dagdae/ClaudeDxfTest/(list of files, cad)

Other CAD files:
output/dxf/07BRW01_RACK-WIRING-ML-B01AM.dxf
output/dxf/07FRW01_RACK-WIRING-ML-F01AM.dxf
output/dxf/07FRW01_S02_NETWORK.dxf
