dagdae/ClaudeDxfTest/output/pdf/07BRW01.pdf

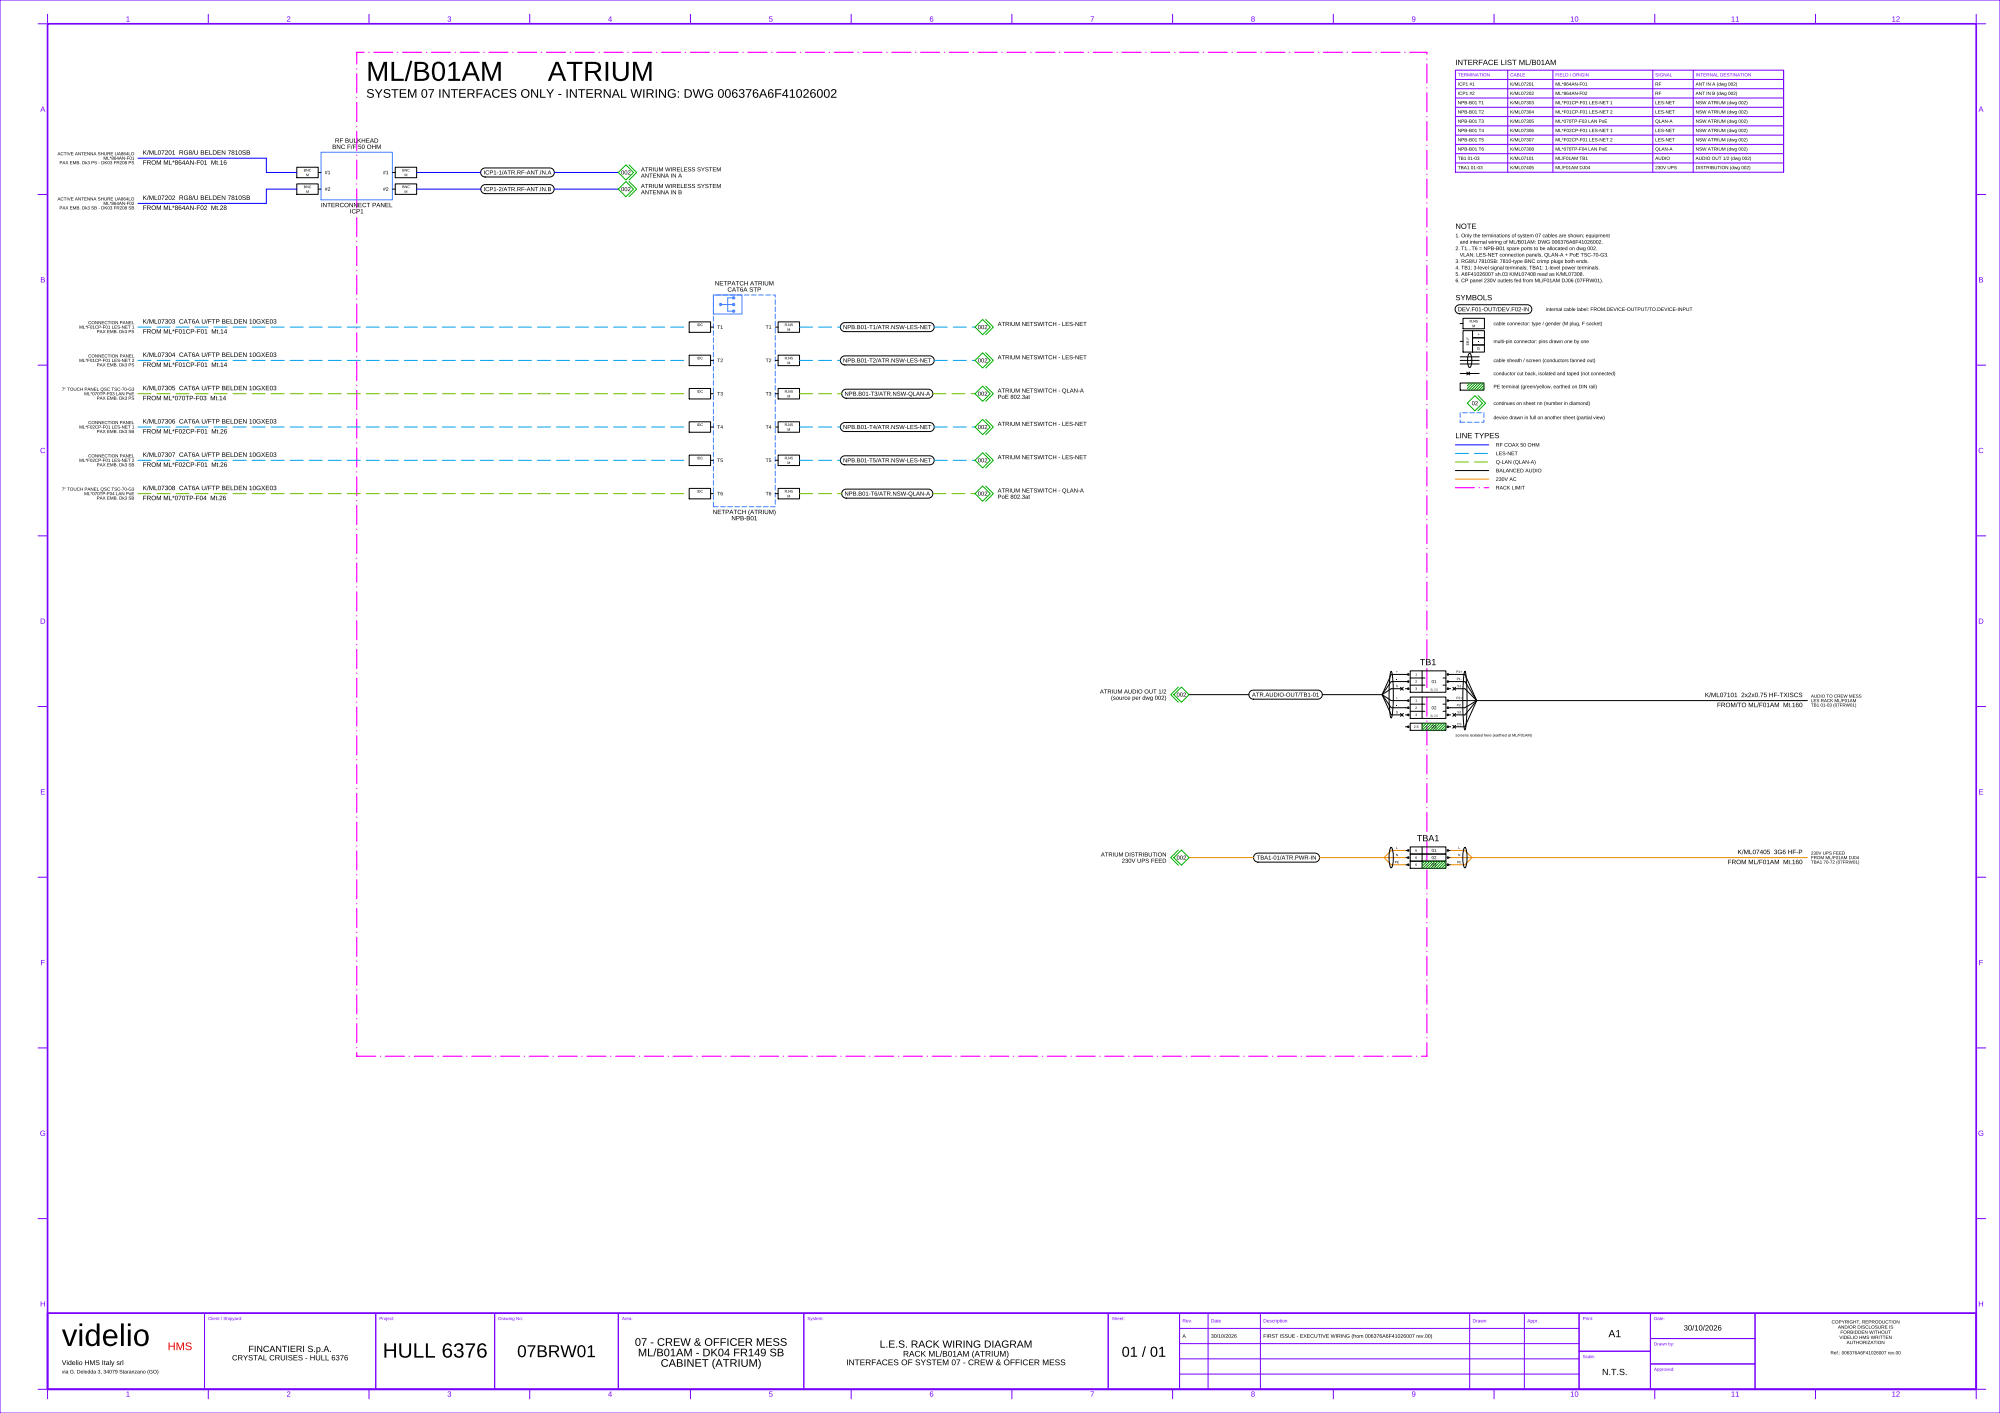
[picture p1: page 1]
