dagdae/ClaudeDxfTest/output/pdf/07FRW01.pdf

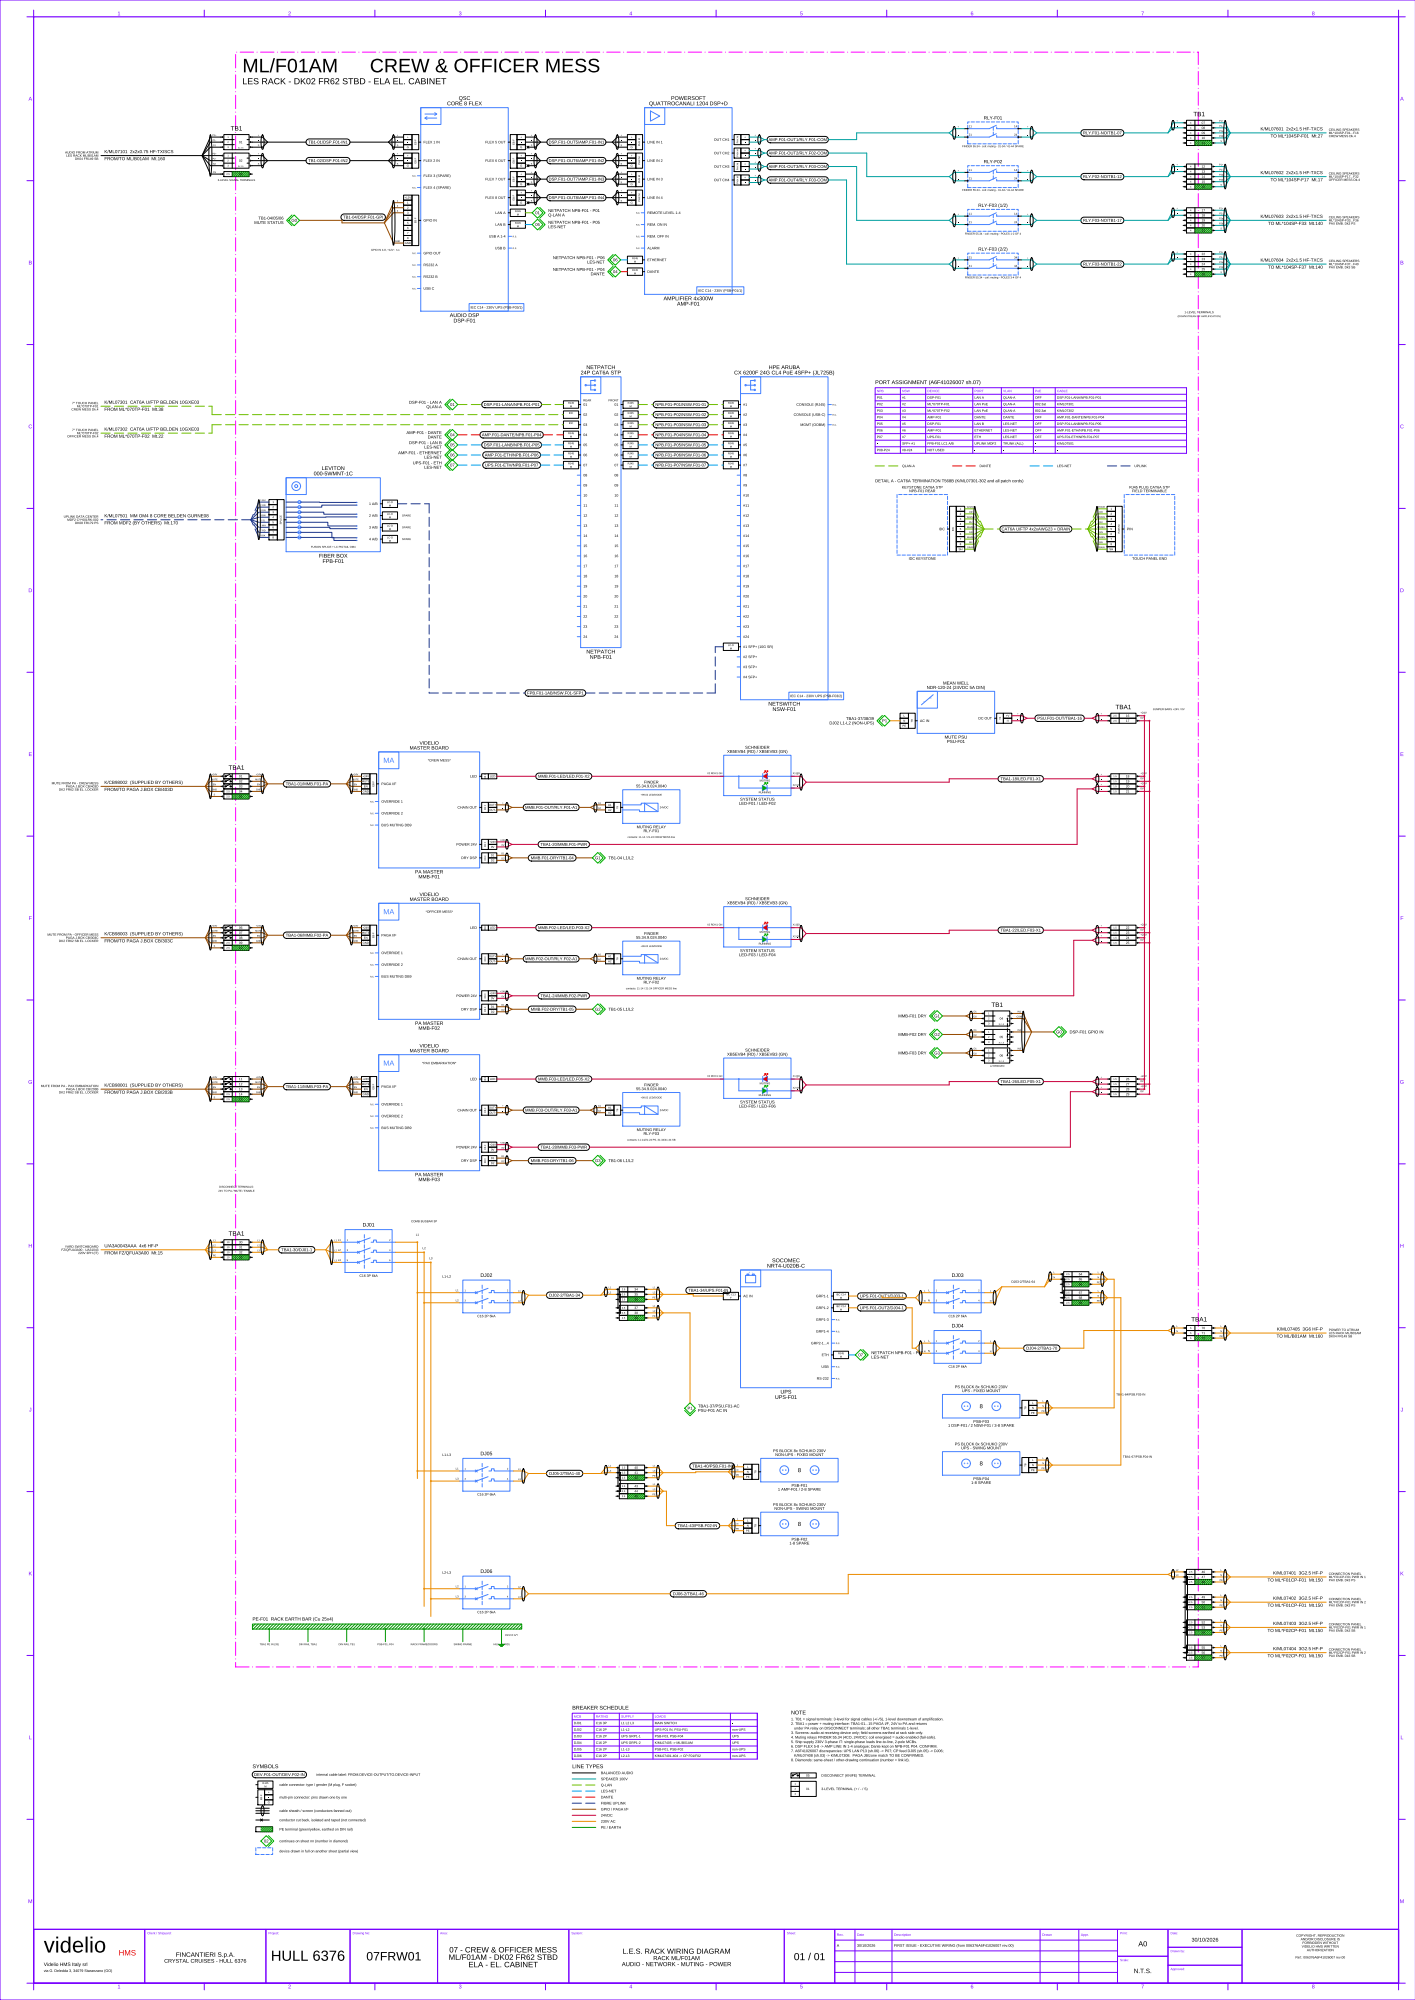
[picture p2: page 1]
