dagdae/ClaudeDxfTest/(commit log)

2026-10-30 Add executive wiring diagrams for LES racks ML/F01AM and ML/B01AM
    Executive rack wiring for Hull 6376 - 07 Officer & Crew Mess, derived
    from the Crystal functional diagrams 006376A6F41026007 and drawn with
    the 21xRWxx method (devices, connectors, pins, conductors, cable labels
    FROM.DEV-OUT/TO.DEV-IN, ship cable numbers).
    - 07FRW01 (ML/F01AM): audio/100V lines, network/fibre, PAGA muting/GPIO/
    24VDC, 230V IT distribution/UPS/earthing (4 x A1, DXF + PDF)
    - 07BRW01 (ML/B01AM): interface terminations of system 07 cables
    - cable_schedule.csv generated from the same data
    - generator/: ezdxf-based drawing engine and sheet sources
    Claude-Se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
    [07BRW01_S01_INTERFACES.dxf, 07FRW01_S01_AUDIO_SPEAKER-LINES.dxf, 07FRW01_S02_NETWORK.dxf, 07FRW01_S03_MUTING_GPIO.dxf, 07FRW01_S04_POWER.dxf, cable_schedule.csv]
2026-10-30 Rework rack wiring as single sheets with TB1/TBA1 terminal conventions
    - ML/F01AM (07FRW01) redrawn as one A0 sheet in 21xRWxx style: audio,
    network/fibre, PAGA muting and 230V distribution on the same sheet
    - field equipment removed: field cables shown with ship number, type and
    FROM/TO only
    - TB1 for signals: 3-level terminals for signal cables, 1-level terminals
    downstream of amplification (100V lines)
    - TBA1 for power and muting interface: PAGA 24V out / MUTE / ENABLE on
    disconnect terminals, all other TBA1 terminals 1-level
    - ML/B01AM (07BRW01) single A1 sheet with the same conventions
    - engine: multi-level and disconnect terminals, field cable end text
    - old 4-sheet drawings an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
    [07BRW01_RACK-WIRING-ML-B01AM.dxf, 07BRW01_S01_INTERFACES.dxf, 07FRW01_RACK-WIRING-ML-F01AM.dxf, 07FRW01_S01_AUDIO_SPEAKER-LINES.dxf, 07FRW01_S03_MUTING_GPIO.dxf, 07FRW01_S04_POWER.dxf, cable_schedule.csv]
